trasors/Commodore-64-Wireless-Joystick/eagle/c64 joystick tx/c64-tx.brd

## EAGLE design eagle/c64 joystick tx/c64-tx.brd (2026-10-10)

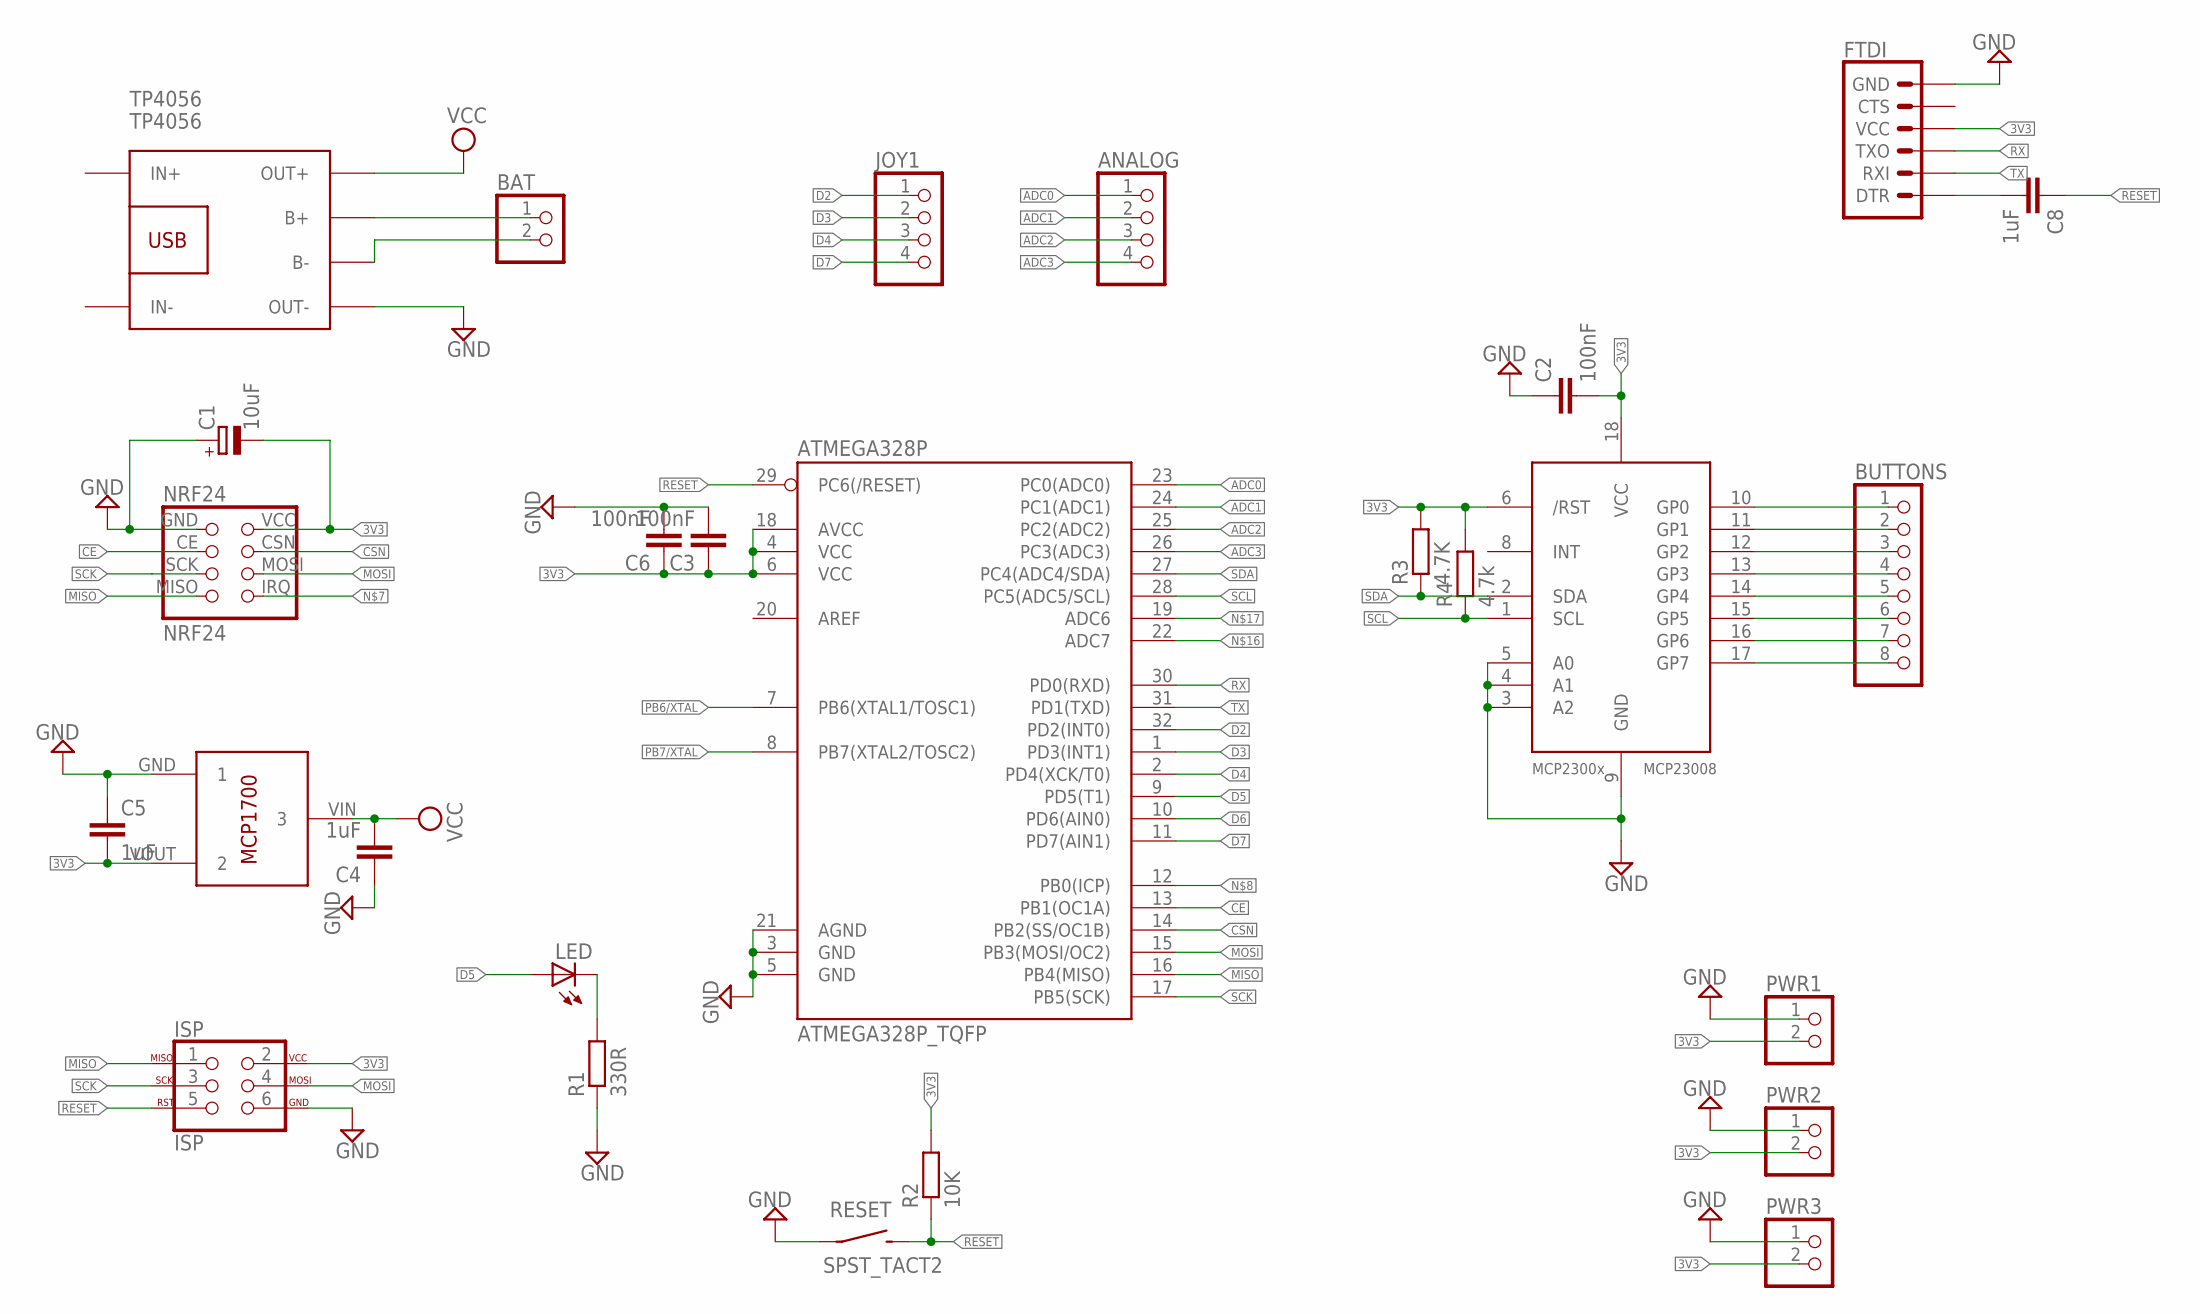
[picture p12: schematic c64-tx.sch]

Parts:
ANALOG: PINHD-1X4; 1X04
ATMEGA328P: ATMEGA328P_TQFP; TQFP32-08
BAT: PINHD-1X2; 1X02
BUTTONS: PINHD-1X8; 1X08
C1: 10uF; A/3216-18W
C2, C3, C6: 100nF; C1206K
C4, C5, C8: 1uF; C1206K
FTDI: 6_PIN_SERIAL_TARGETPTH-KIT; 1X06-KIT
ISP: ISP; 2X3-NS
JOY1: PINHD-1X4; 1X04
LED: LEDSMT1206; 1206
MCP1700: MCP1700T-3302E/TT
MCP23008: MCP23008/SO; SO18W
NRF24: NRF24; NRF24-PCB
PWR1, PWR2, PWR3: PINHD-1X2; 1X02
R1: 330R; M1206
R2: 10K; M1206
R3: 4.7K; M1206
R4: 4.7k; M1206
RESET: SPST_TACT2; 6MMTACTILE
TP4056: TP4056; BATTERY-CHARGER-LI-PROT

Connections:
3V3: ATMEGA328P.4 (VCC), ATMEGA328P.6 (VCC), ATMEGA328P.18 (AVCC), C1.-, C2.2, C3.1, C5.2, C6.1, FTDI.4 (VCC), ISP.2, MCP1700.VOUT (2), MCP23008.6 (/RST), MCP23008.18 (VCC), NRF24.VCC, PWR1.2, PWR2.2, PWR3.2, R2.2, R3.2, R4.2
ADC0: ANALOG.1, ATMEGA328P.23 (PC0(ADC0))
ADC1: ANALOG.2, ATMEGA328P.24 (PC1(ADC1))
ADC2: ANALOG.3, ATMEGA328P.25 (PC2(ADC2))
ADC3: ANALOG.4, ATMEGA328P.26 (PC3(ADC3))
B+: BAT.1, TP4056.B+
B-: BAT.2, TP4056.B-
CE: ATMEGA328P.13 (PB1(OC1A)), NRF24.CE
CSN: ATMEGA328P.14 (PB2(SS/OC1B)), NRF24.CSN
D2: ATMEGA328P.32 (PD2(INT0)), JOY1.1
D3: ATMEGA328P.1 (PD3(INT1)), JOY1.2
D4: ATMEGA328P.2 (PD4(XCK/T0)), JOY1.3
D5: ATMEGA328P.9 (PD5(T1)), LED.A
D6: ATMEGA328P.10 (PD6(AIN0))
D7: ATMEGA328P.11 (PD7(AIN1)), JOY1.4
GND: ATMEGA328P.3 (GND), ATMEGA328P.5 (GND), ATMEGA328P.21 (AGND), C1.+, C2.1, C3.2, C4.1, C5.1, C6.2, FTDI.6 (GND), ISP.6, MCP1700.GND (1), MCP23008.3 (A2), MCP23008.4 (A1), MCP23008.5 (A0), MCP23008.9 (GND), NRF24.GND, PWR1.1, PWR2.1, PWR3.1, R1.1, RESET.P$1, TP4056.OUT-
MISO: ATMEGA328P.16 (PB4(MISO)), ISP.1, NRF24.MISO
MOSI: ATMEGA328P.15 (PB3(MOSI/OC2)), ISP.4, NRF24.MOSI
unnamed: BUTTONS.1, MCP23008.10 (GP0)
unnamed: LED.C, R1.2
unnamed: BUTTONS.2, MCP23008.11 (GP1)
unnamed: BUTTONS.3, MCP23008.12 (GP2)
unnamed: BUTTONS.4, MCP23008.13 (GP3)
unnamed: BUTTONS.5, MCP23008.14 (GP4)
unnamed: BUTTONS.6, MCP23008.15 (GP5)
unnamed: BUTTONS.7, MCP23008.16 (GP6)
unnamed: BUTTONS.8, MCP23008.17 (GP7)
unnamed: C8.2, FTDI.1 (DTR)
PB6/XTAL: ATMEGA328P.7 (PB6(XTAL1/TOSC1))
PB7/XTAL: ATMEGA328P.8 (PB7(XTAL2/TOSC2))
RESET: ATMEGA328P.29 (PC6(/RESET)), C8.1, ISP.5, R2.1, RESET.P$2 (S)
RX: ATMEGA328P.30 (PD0(RXD)), FTDI.3 (TXO)
SCK: ATMEGA328P.17 (PB5(SCK)), ISP.3, NRF24.SCK
SCL: ATMEGA328P.28 (PC5(ADC5/SCL)), MCP23008.1 (SCL), R4.1
SDA: ATMEGA328P.27 (PC4(ADC4/SDA)), MCP23008.2 (SDA), R3.1
TX: ATMEGA328P.31 (PD1(TXD)), FTDI.2 (RXI)
VCC: C4.2, MCP1700.VIN (3), TP4056.OUT+

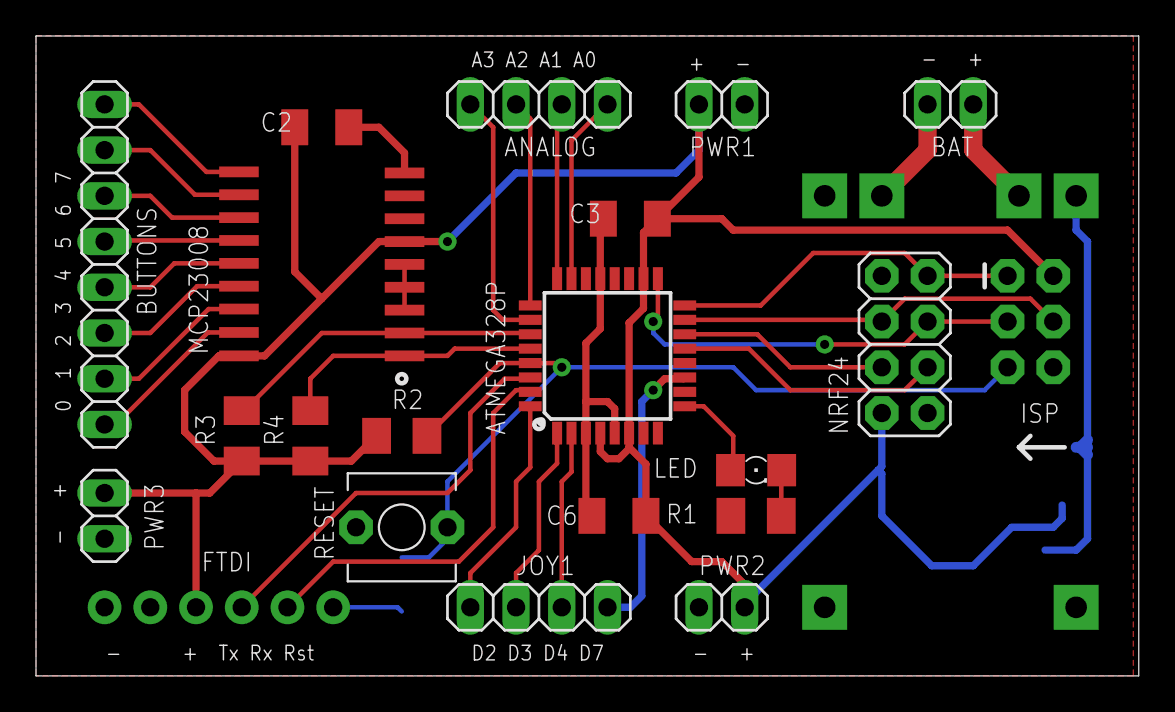
[picture p13: board c64-tx.brd from above]

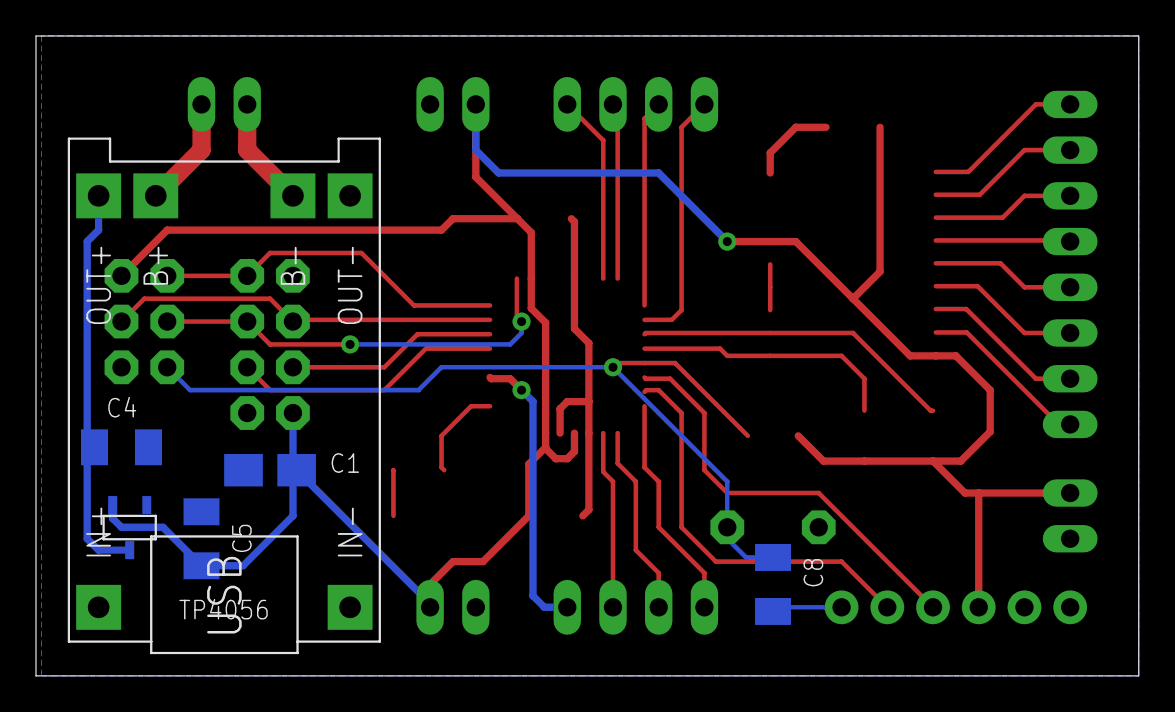
[picture p14: board c64-tx.brd from below]

Board: 2 copper layers, 61.3 x 35.5 mm, 27 parts (6 on the bottom side), 34 nets.
