trasors/Commodore-64-Wireless-Joystick/eagle/c64 joystick rx/c64-rx.brd

## EAGLE design eagle/c64 joystick rx/c64-rx.brd (2026-10-10)

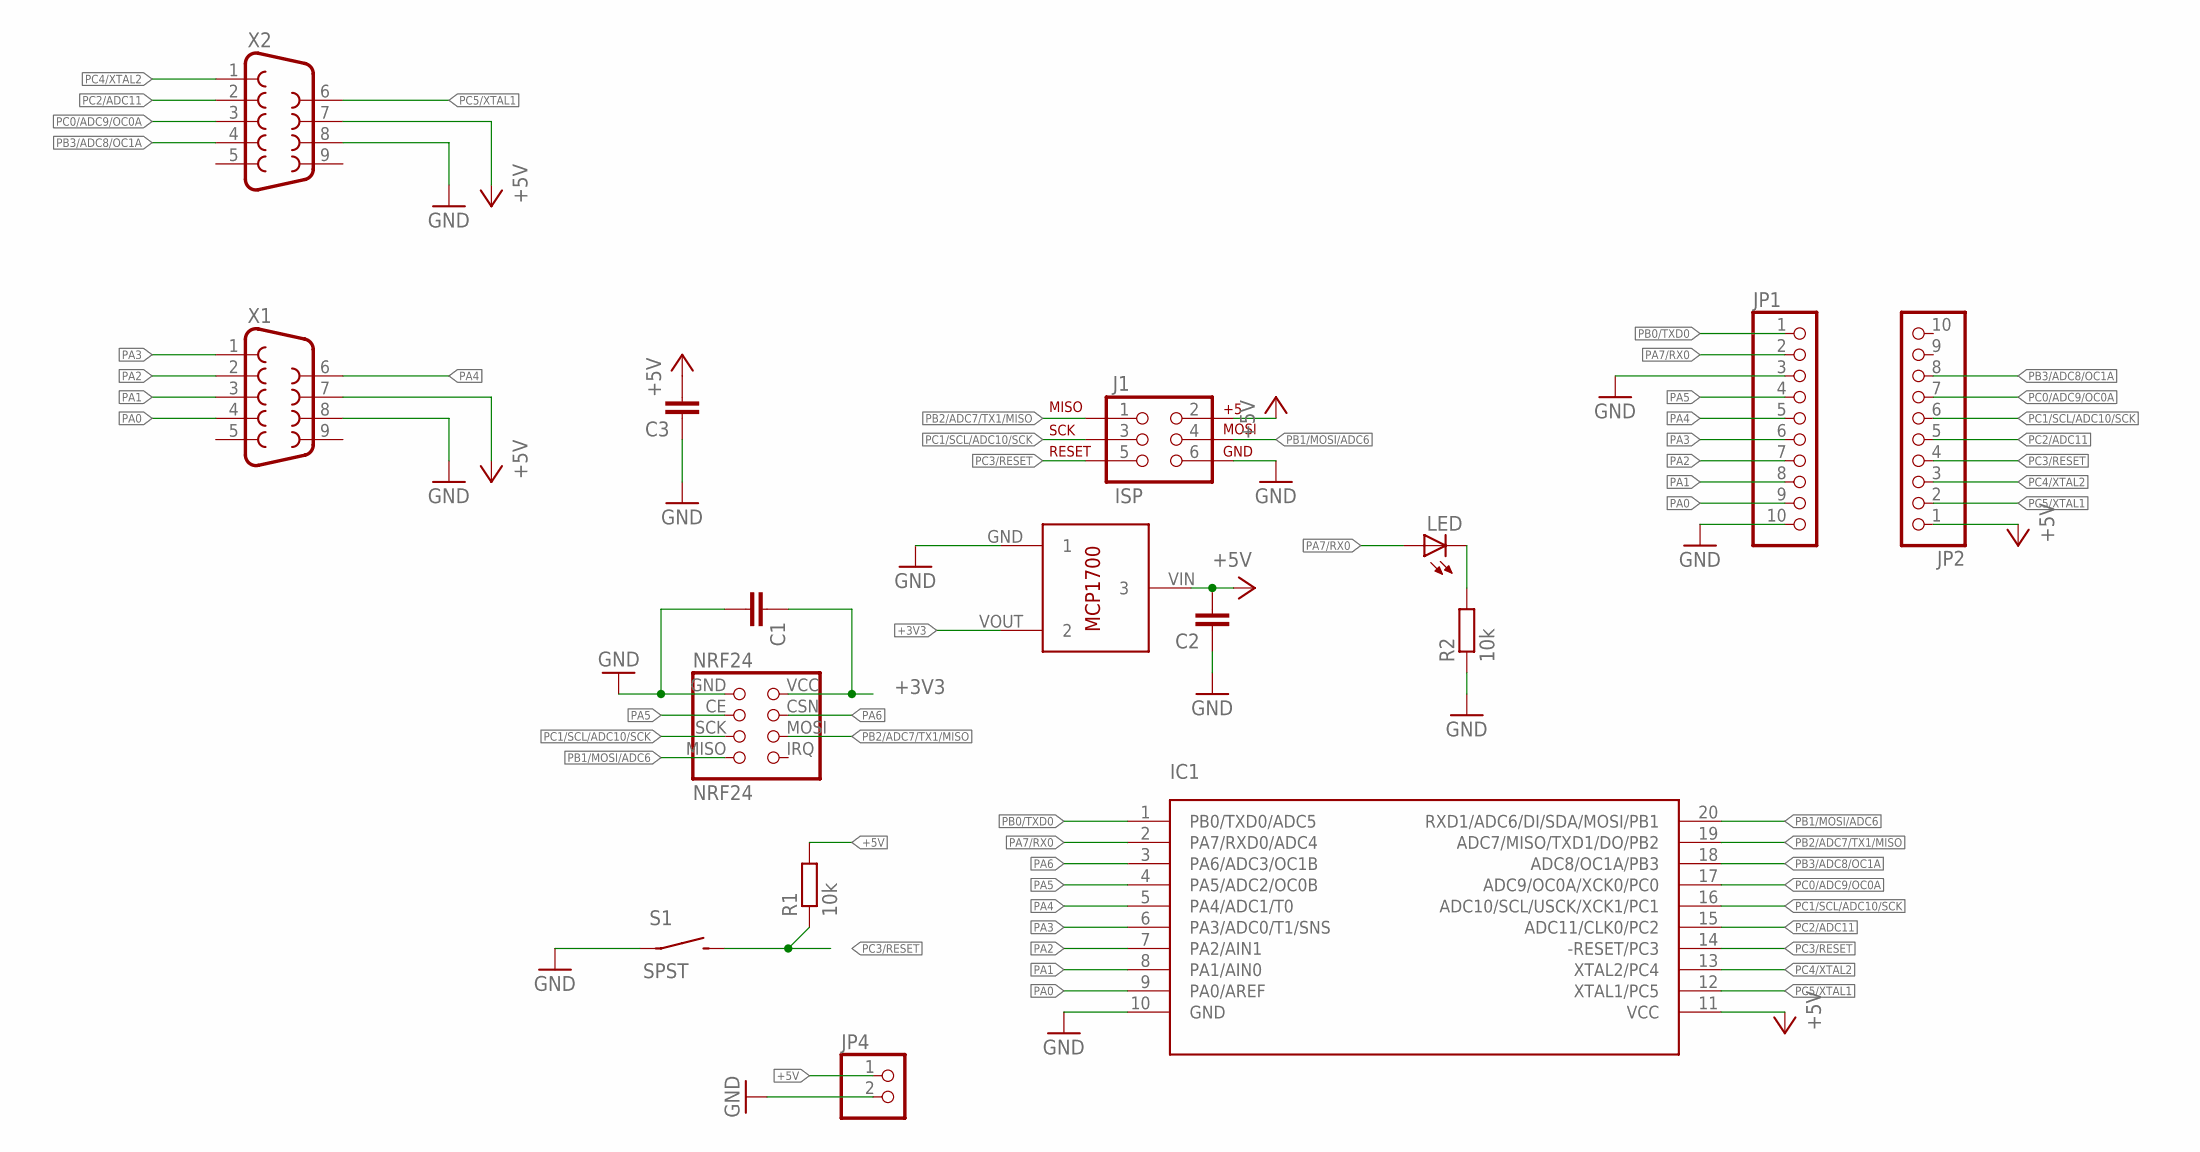
[picture p15: schematic c64-rx.sch]

Parts:
C1, C2, C3: C-EUC1206K; C1206K
IC1: ATTINY1634; SOIC20
J1: ISP; 2X3-NS
JP1, JP2: PINHD-1X10; 1X10
JP4: PINHD-1X2; 1X02
LED: LEDSMT1206; 1206
NRF24: NRF24
R1, R2: 10k; M1206
S1: SPST; OFFBOARD_2_LG
U$3: MCP1700T-3302E/TT
X1, X2: F09D

Connections:
+3V3: C1.1, NRF24.VCC, U$3.VOUT (2)
+5V: C2.2, C3.2, IC1.11 (VCC), J1.2, JP2.1, JP4.1, R1.2, U$3.VIN (3), X1.7, X2.7
GND: C1.2, C2.1, C3.1, IC1.10 (GND), J1.6, JP1.3, JP1.10, JP4.2, NRF24.GND, R2.1, S1.P$1, U$3.GND (1), X1.8, X2.8
unnamed: LED.C, R2.2
PA0: IC1.9 (PA0/AREF), JP1.9, X1.4
PA1: IC1.8 (PA1/AIN0), JP1.8, X1.3
PA2: IC1.7 (PA2/AIN1), JP1.7, X1.2
PA3: IC1.6 (PA3/ADC0/T1/SNS), JP1.6, X1.1
PA4: IC1.5 (PA4/ADC1/T0), JP1.5, X1.6
PA5: IC1.4 (PA5/ADC2/OC0B), JP1.4, NRF24.CE
PA6: IC1.3 (PA6/ADC3/OC1B), NRF24.CSN
PA7/RX0: IC1.2 (PA7/RXD0/ADC4), JP1.2, LED.A
PB0/TXD0: IC1.1 (PB0/TXD0/ADC5), JP1.1
PB1/MOSI/ADC6: IC1.20 (RXD1/ADC6/DI/SDA/MOSI/PB1), J1.4, NRF24.MISO
PB2/ADC7/TX1/MISO: IC1.19 (ADC7/MISO/TXD1/DO/PB2), J1.1, NRF24.MOSI
PB3/ADC8/OC1A: IC1.18 (ADC8/OC1A/PB3), JP2.8, X2.4
PC0/ADC9/OC0A: IC1.17 (ADC9/OC0A/XCK0/PC0), JP2.7, X2.3
PC1/SCL/ADC10/SCK: IC1.16 (ADC10/SCL/USCK/XCK1/PC1), J1.3, JP2.6, NRF24.SCK
PC2/ADC11: IC1.15 (ADC11/CLK0/PC2), JP2.5, X2.2
PC3/RESET: IC1.14 (-RESET/PC3), J1.5, JP2.4, R1.1, S1.P$2 (S)
PC4/XTAL2: IC1.13 (XTAL2/PC4), JP2.3, X2.1
PC5/XTAL1: IC1.12 (XTAL1/PC5), JP2.2, X2.6

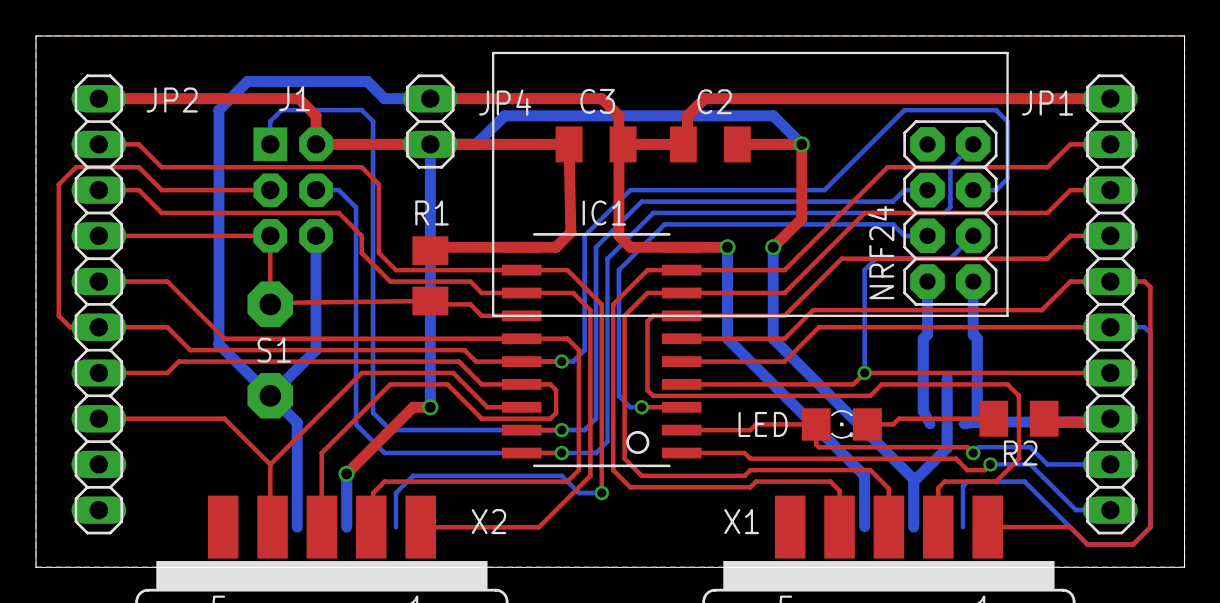
[picture p16: board c64-rx.brd from above]

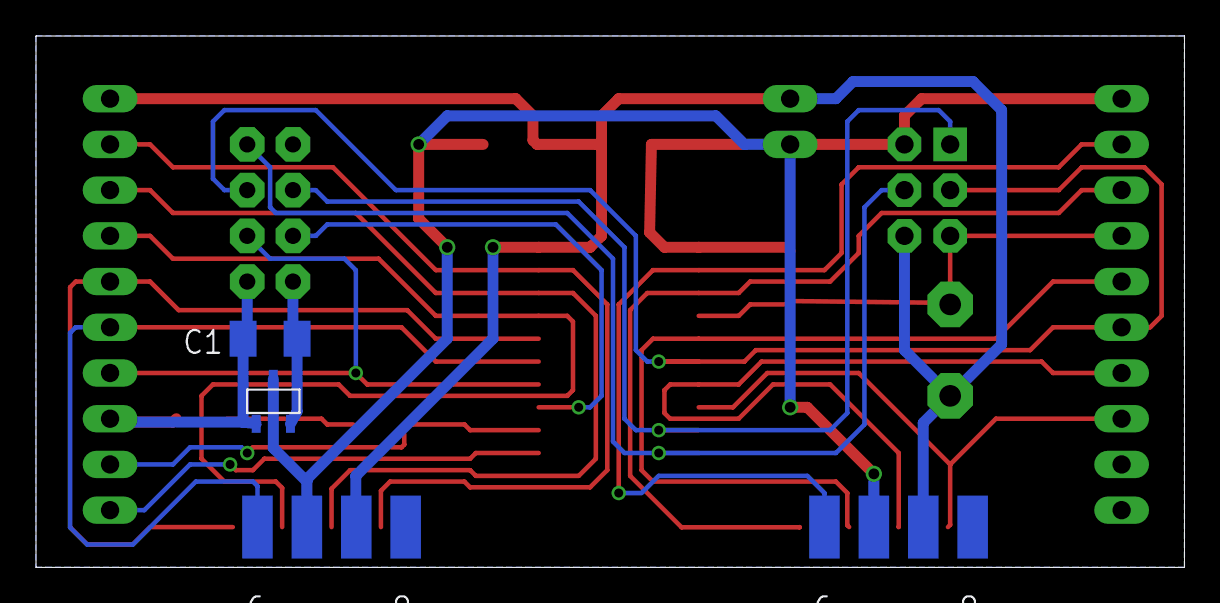
[picture p17: board c64-rx.brd from below]

Board: 2 copper layers, 63.8 x 29.5 mm, 16 parts (2 on the bottom side), 22 nets.
